slinkyfish/ISC-Project/119_INTELLIGENT_SENSOR_BOARD/119_02v2_INTELLIGENT_SENSOR_BOARD.brd

## EAGLE design 119_INTELLIGENT_SENSOR_BOARD/119_02v2_INTELLIGENT_SENSOR_BOARD.brd (2021-02-11, last stored version)

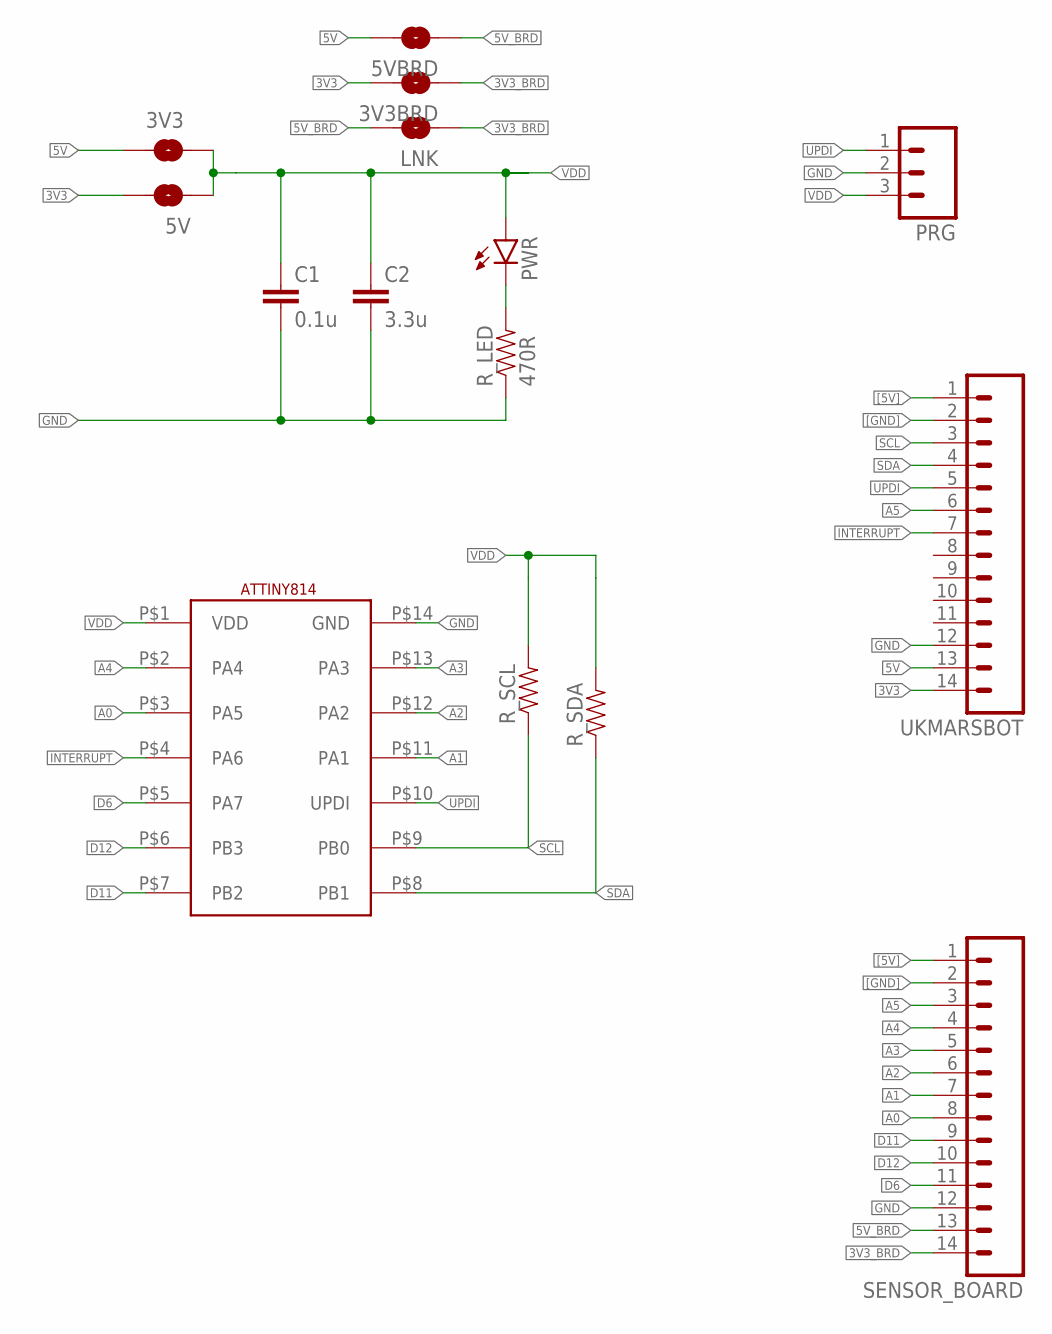
[picture p8: schematic 119_02v2_INTELLIGENT_SENSOR_BOARD.sch]

Parts:
3V3, 3V3BRD, 5V, 5VBRD: JUMPER-SMT_2_NO_SILK; SMT-JUMPER_2_NO_SILK
C1: 0.1u; 0805
C2: 3.3u; 0805
LNK: JUMPER-SMT_2_NO_SILK; SMT-JUMPER_2_NO_SILK
PRG: M03PTH; 1X03
PWR: LEDCHIP-LED0805; CHIP-LED0805
R_LED: 470R; 0805
R_SCL: RESISTOR0805-RES; 0805
R_SDA: RESISTOR0805-RES; 0805
SENSOR_BOARD: M14; 1X14
U$1: ATTINY814
UKMARSBOT: M14; 1X14

Connections:
3V3: 3V3BRD.2, 5V.2, UKMARSBOT.14
3V3_BRD: 3V3BRD.1, LNK.1, SENSOR_BOARD.14
5V: 3V3.2, 5VBRD.2, UKMARSBOT.13
5V_BRD: 5VBRD.1, LNK.2, SENSOR_BOARD.13
A0: SENSOR_BOARD.8, U$1.P$3 (PA5)
A1: SENSOR_BOARD.7, U$1.P$11 (PA1)
A2: SENSOR_BOARD.6, U$1.P$12 (PA2)
A3: SENSOR_BOARD.5, U$1.P$13 (PA3)
A4: SENSOR_BOARD.4, U$1.P$2 (PA4)
A5: SENSOR_BOARD.3, UKMARSBOT.6
D6: SENSOR_BOARD.11, U$1.P$5 (PA7)
D11: SENSOR_BOARD.9, U$1.P$7 (PB2)
D12: SENSOR_BOARD.10, U$1.P$6 (PB3)
GND: C1.2, C2.2, PRG.2, R_LED.1, SENSOR_BOARD.12, U$1.P$14 (GND), UKMARSBOT.12
INTERRUPT: U$1.P$4 (PA6), UKMARSBOT.7
unnamed: PWR.C, R_LED.2
SCL: R_SCL.1, U$1.P$9 (PB0), UKMARSBOT.3
SDA: R_SDA.1, U$1.P$8 (PB1), UKMARSBOT.4
UPDI: PRG.1, U$1.P$10 (UPDI), UKMARSBOT.5
VDD: 3V3.1, 5V.1, C1.1, C2.1, PRG.3, PWR.A, R_SCL.2, R_SDA.2, U$1.P$1 (VDD)
[5V]: SENSOR_BOARD.1, UKMARSBOT.1
[GND]: SENSOR_BOARD.2, UKMARSBOT.2

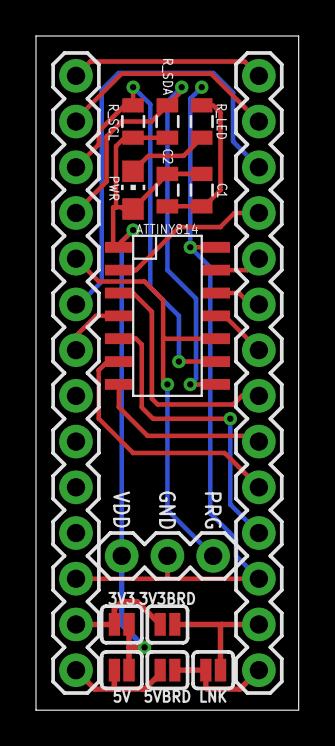
[picture p9: board 119_02v2_INTELLIGENT_SENSOR_BOARD.brd from above]

Board: 2 copper layers, 14.6 x 37.5 mm, 15 parts (0 on the bottom side), 22 nets.
