slinkyfish/ISC-Project/119_INTELLIGENT_SENSOR_BOARD/119_03_INTELLIGENT_SENSOR_BOARD_816.brd

## EAGLE design 119_INTELLIGENT_SENSOR_BOARD/119_03_INTELLIGENT_SENSOR_BOARD_816.brd (2021-02-10, last stored version)

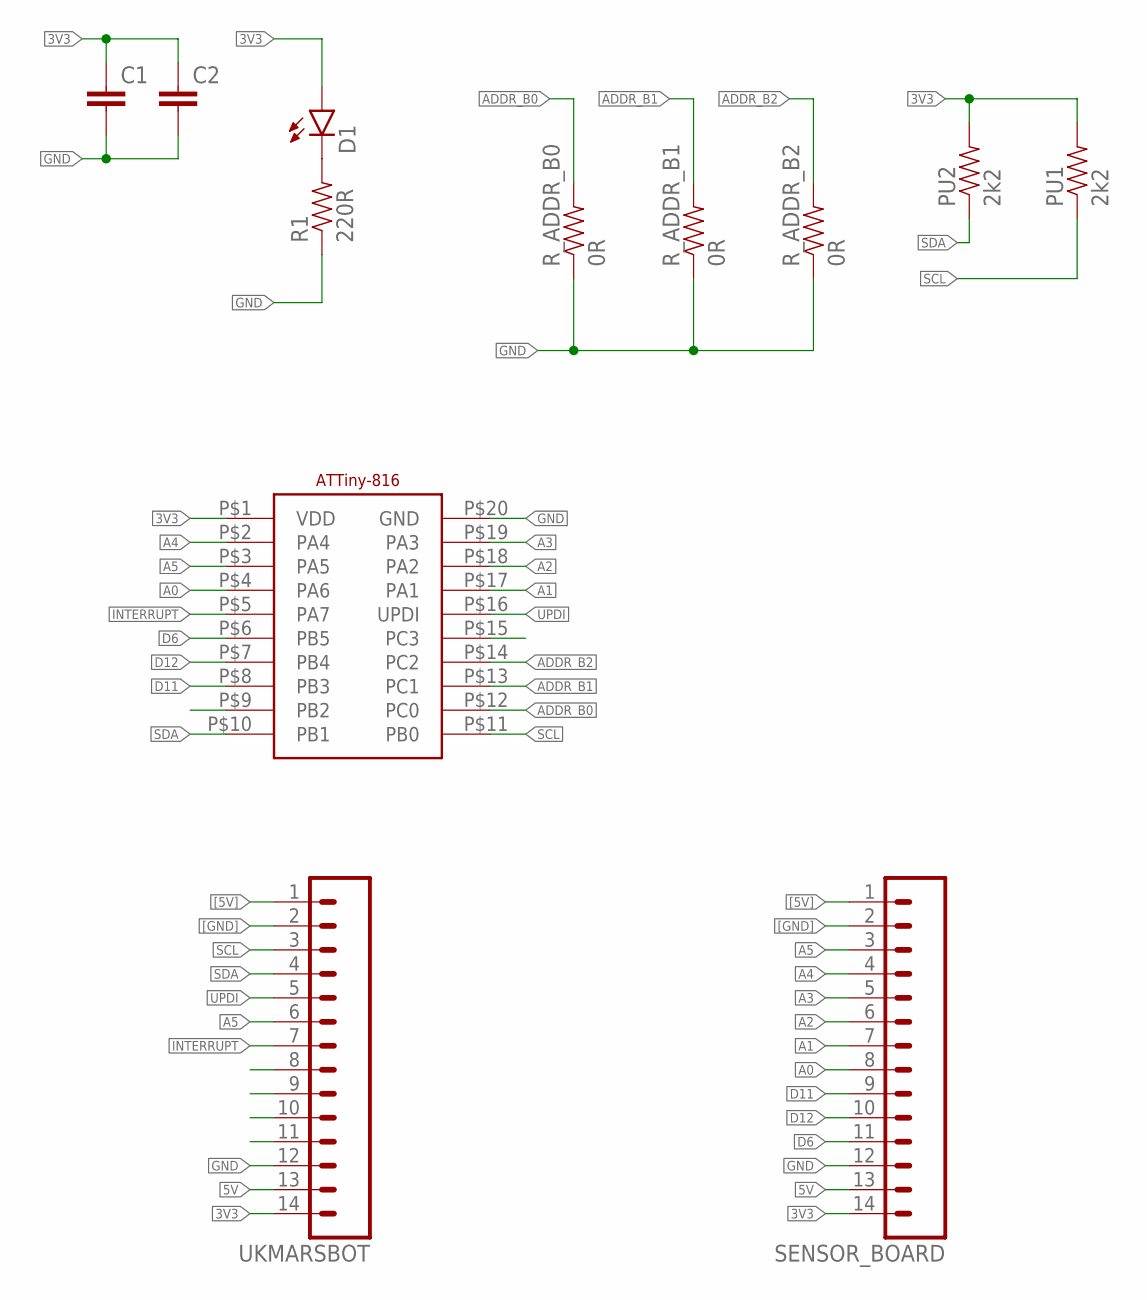
[picture p10: schematic 119_03_INTELLIGENT_SENSOR_BOARD_816.sch]

Parts:
C1, C2: CAP0805; 0805
D1: LEDCHIP-LED0805; CHIP-LED0805
PU1, PU2: 2k2; 0805
R1: 220R; 0805
R_ADDR_B0, R_ADDR_B1, R_ADDR_B2: 0R; 0805
SENSOR_BOARD: M14; 14P
U$2: ATTINY816; ATTINY816_SOIC20
UKMARSBOT: M14; 14P

Connections:
3V3: C1.1, C2.1, D1.A, PU1.2, PU2.2, SENSOR_BOARD.14, U$2.P$1 (VDD), UKMARSBOT.14
5V: SENSOR_BOARD.13, UKMARSBOT.13
A0: SENSOR_BOARD.8, U$2.P$4 (PA6)
A1: SENSOR_BOARD.7, U$2.P$17 (PA1)
A2: SENSOR_BOARD.6, U$2.P$18 (PA2)
A3: SENSOR_BOARD.5, U$2.P$19 (PA3)
A4: SENSOR_BOARD.4, U$2.P$2 (PA4)
A5: SENSOR_BOARD.3, U$2.P$3 (PA5), UKMARSBOT.6
ADDR_B0: R_ADDR_B0.2, U$2.P$12 (PC0)
ADDR_B1: R_ADDR_B1.2, U$2.P$13 (PC1)
ADDR_B2: R_ADDR_B2.2, U$2.P$14 (PC2)
D6: SENSOR_BOARD.11, U$2.P$6 (PB5)
D11: SENSOR_BOARD.9, U$2.P$8 (PB3)
D12: SENSOR_BOARD.10, U$2.P$7 (PB4)
GND: C1.2, C2.2, R1.1, R_ADDR_B0.1, R_ADDR_B1.1, R_ADDR_B2.1, SENSOR_BOARD.12, U$2.P$20 (GND), UKMARSBOT.12
INTERRUPT: U$2.P$5 (PA7), UKMARSBOT.7
unnamed: D1.C, R1.2
SCL: PU1.1, U$2.P$11 (PB0), UKMARSBOT.3
SDA: PU2.1, U$2.P$10 (PB1), UKMARSBOT.4
UPDI: U$2.P$16 (UPDI), UKMARSBOT.5
[5V]: SENSOR_BOARD.1, UKMARSBOT.1
[GND]: SENSOR_BOARD.2, UKMARSBOT.2

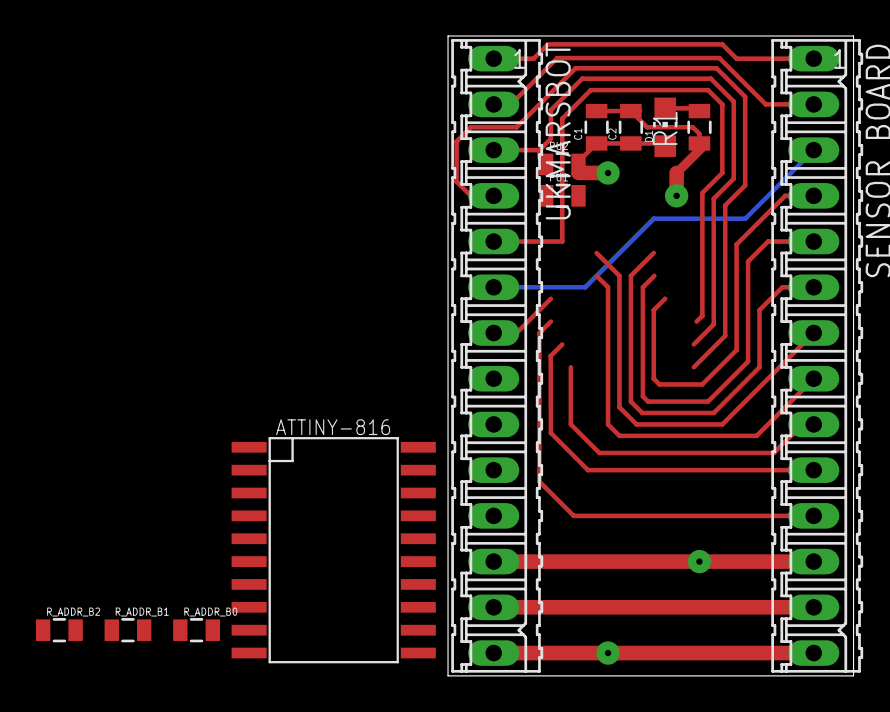
[picture p11: board 119_03_INTELLIGENT_SENSOR_BOARD_816.brd from above]

Board: 2 copper layers, 22.5 x 35.5 mm, 12 parts (0 on the bottom side), 22 nets.
