slinkyfish/ISC-Project/120_ISC_BASE_BOARD/120_01_ISC_BASE_BOARD.brd

## EAGLE design 120_ISC_BASE_BOARD/120_01_ISC_BASE_BOARD.brd (2021-02-10, last stored version)

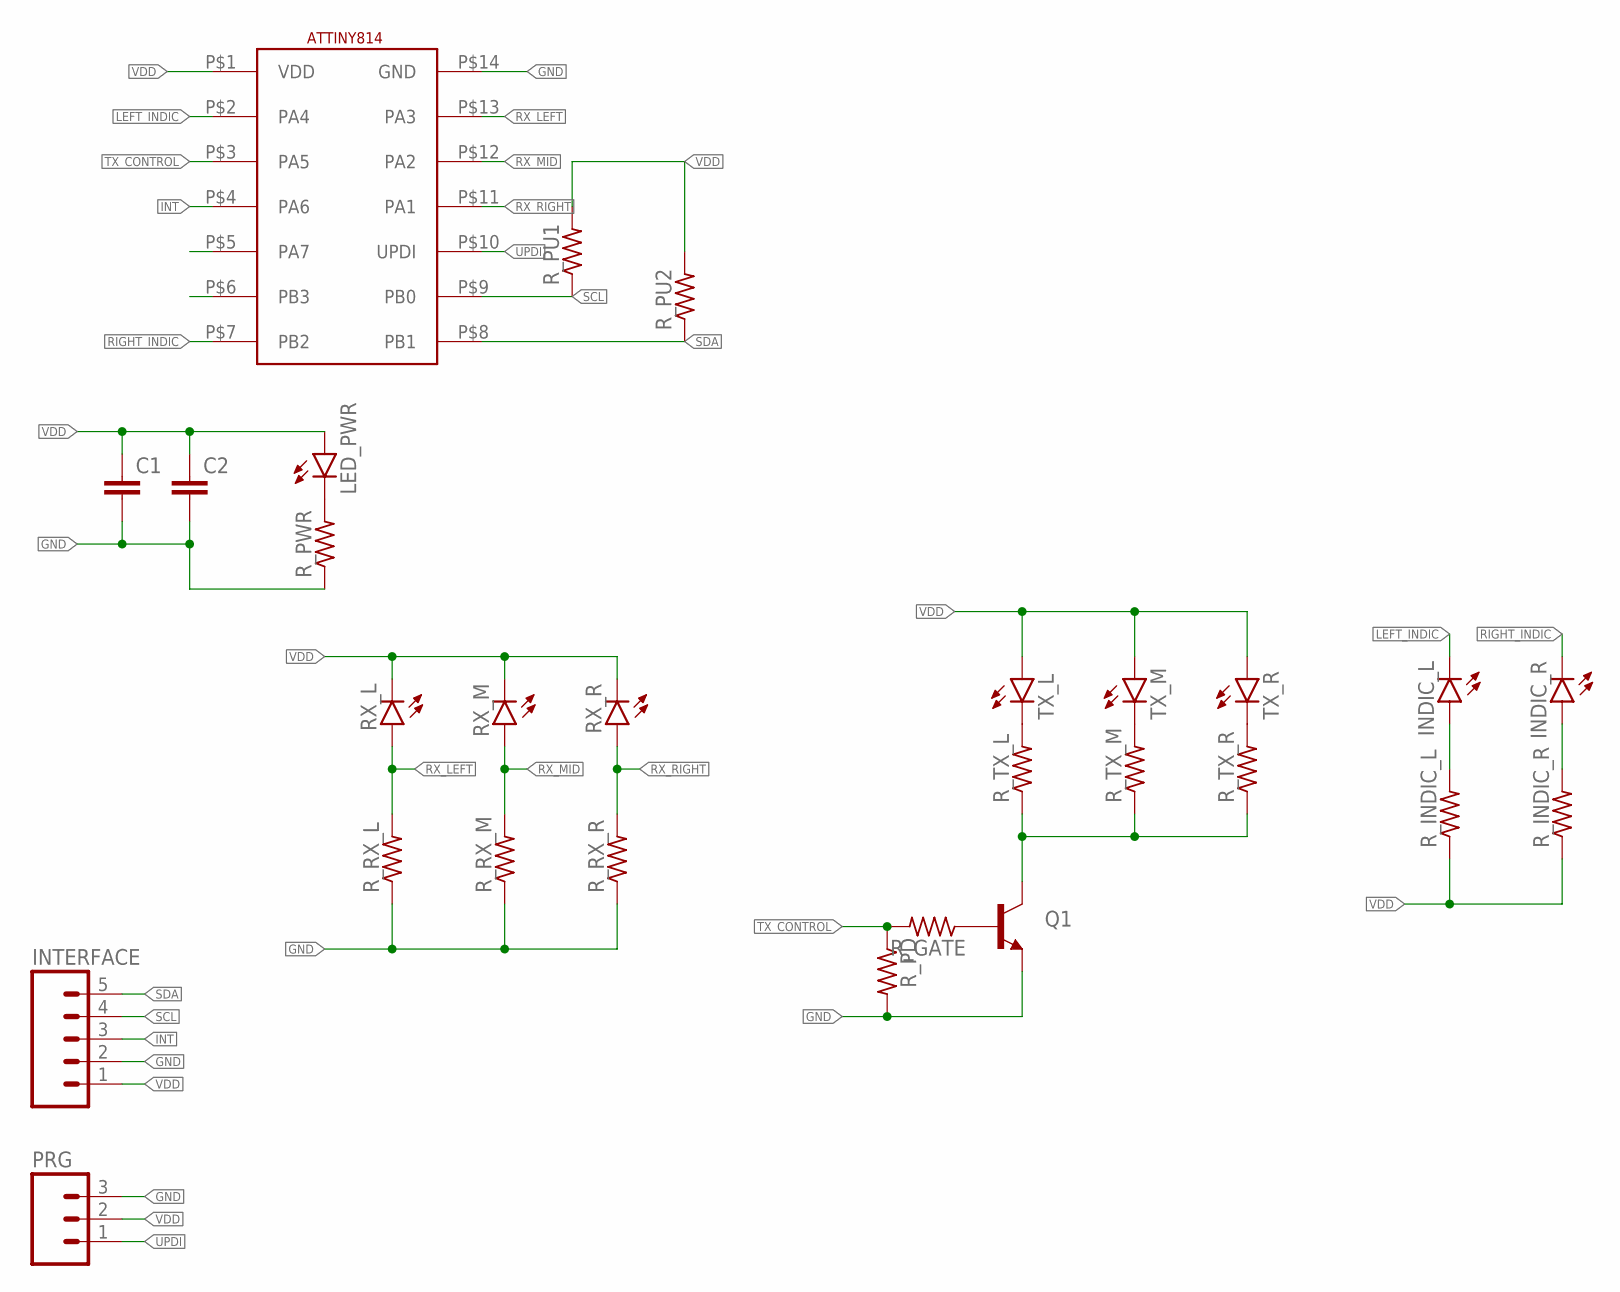
[picture p12: schematic 120_01_ISC_BASE_BOARD.sch]

Parts:
C1, C2: C-EUC0805; C0805
INDIC_L: LED3MM
INDIC_R: LED3MM
INTERFACE: M05NO_SILK; 1X05_NO_SILK
LED_PWR: LEDCHIP-LED0805; CHIP-LED0805
PRG: M03PTH; 1X03
Q1: TRANSISTOR_NPNBC547; TO-92-AMMO
RX_L: LED3MM
RX_M: LED3MM
RX_R: LED3MM
R_GATE: R-US_R0805; R0805
R_INDIC_L: R-US_R0805; R0805
R_INDIC_R: R-US_R0805; R0805
R_PD: R-US_R0805; R0805
R_PU1, R_PU2: R-US_R0805; R0805
R_PWR: R-US_R0805; R0805
R_RX_L: R-US_R0805; R0805
R_RX_M: R-US_R0805; R0805
R_RX_R: R-US_R0805; R0805
R_TX_L: R-US_R0805; R0805
R_TX_M: R-US_R0805; R0805
R_TX_R: R-US_R0805; R0805
TX_L: LED5MM
TX_M: LED5MM
TX_R: LED5MM
U$1: ATTINY814

Connections:
GND: C1.2, C2.2, INTERFACE.2, PRG.3, Q1.3 (E), R_PD.2, R_PWR.1, R_RX_L.1, R_RX_M.1, R_RX_R.1, U$1.P$14 (GND)
INT: INTERFACE.3, U$1.P$4 (PA6)
LEFT_INDIC: INDIC_L.K (C), U$1.P$2 (PA4)
unnamed: LED_PWR.C, R_PWR.2
unnamed: INDIC_L.A, R_INDIC_L.2
unnamed: INDIC_R.A, R_INDIC_R.2
unnamed: R_TX_L.2, TX_L.K (C)
unnamed: R_TX_M.2, TX_M.K (C)
unnamed: R_TX_R.2, TX_R.K (C)
unnamed: Q1.1 (C), R_TX_L.1, R_TX_M.1, R_TX_R.1
unnamed: Q1.2 (B), R_GATE.1
RIGHT_INDIC: INDIC_R.K (C), U$1.P$7 (PB2)
RX_LEFT: RX_L.A, R_RX_L.2, U$1.P$13 (PA3)
RX_MID: RX_M.A, R_RX_M.2, U$1.P$12 (PA2)
RX_RIGHT: RX_R.A, R_RX_R.2, U$1.P$11 (PA1)
SCL: INTERFACE.4, R_PU1.1, U$1.P$9 (PB0)
SDA: INTERFACE.5, R_PU2.1, U$1.P$8 (PB1)
TX_CONTROL: R_GATE.2, R_PD.1, U$1.P$3 (PA5)
UPDI: PRG.1, U$1.P$10 (UPDI)
VDD: C1.1, C2.1, INTERFACE.1, LED_PWR.A, PRG.2, RX_L.K (C), RX_M.K (C), RX_R.K (C), R_INDIC_L.1, R_INDIC_R.1, R_PU1.2, R_PU2.2, TX_L.A, TX_M.A, TX_R.A, U$1.P$1 (VDD)

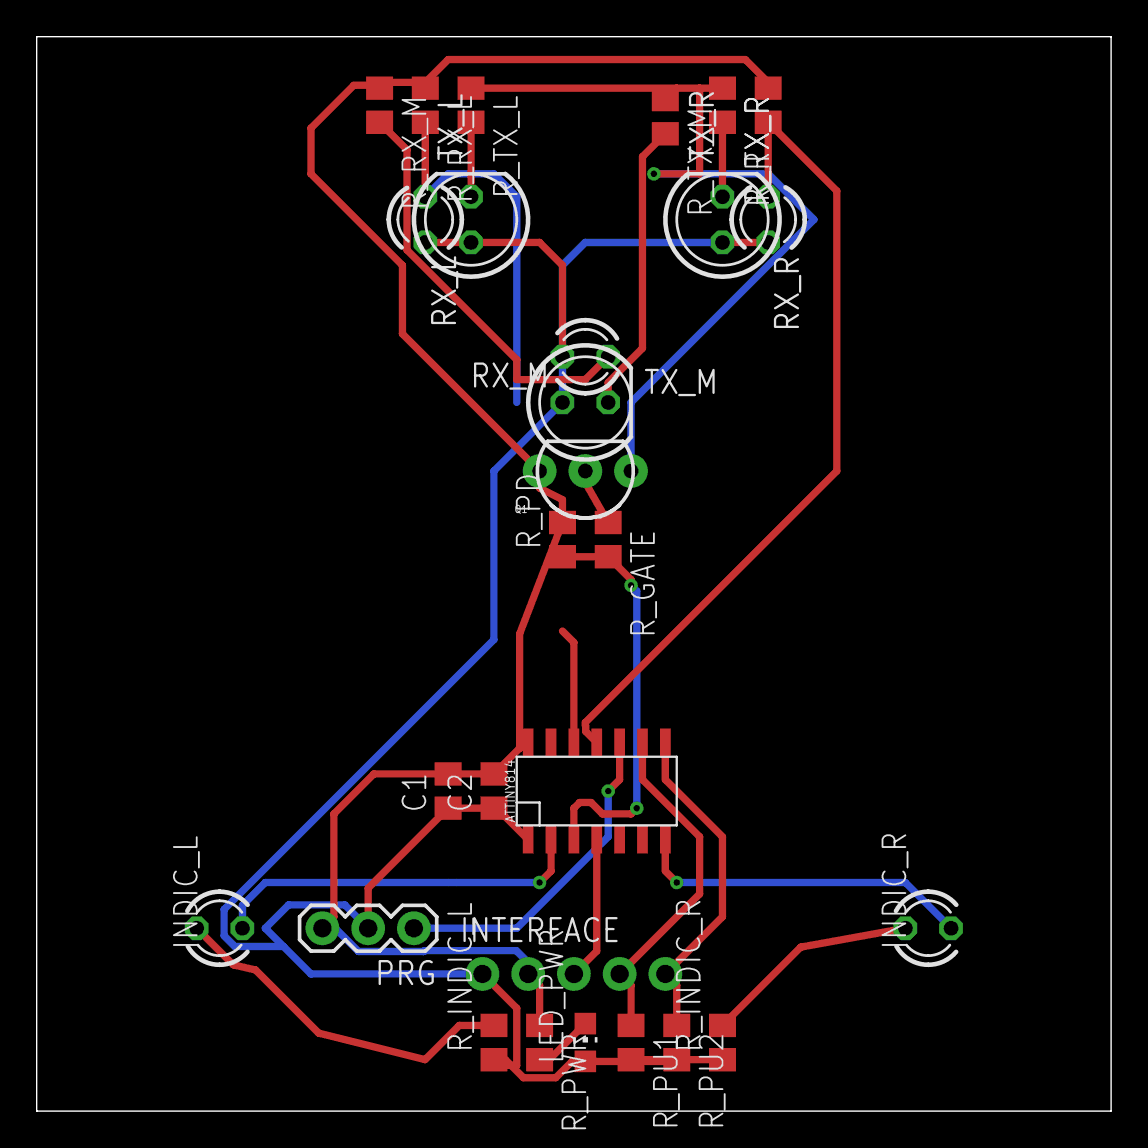
[picture p13: board 120_01_ISC_BASE_BOARD.brd from above]

Board: 2 copper layers, 59.7 x 59.7 mm, 28 parts (0 on the bottom side), 20 nets.
