slinkyfish/ISC-Project/119_INTELLIGENT_SENSOR_BOARD/119_01_INTELLIGENT_SENSOR_BOARD.brd

## EAGLE design 119_INTELLIGENT_SENSOR_BOARD/119_01_INTELLIGENT_SENSOR_BOARD.brd (2021-02-10, last stored version)

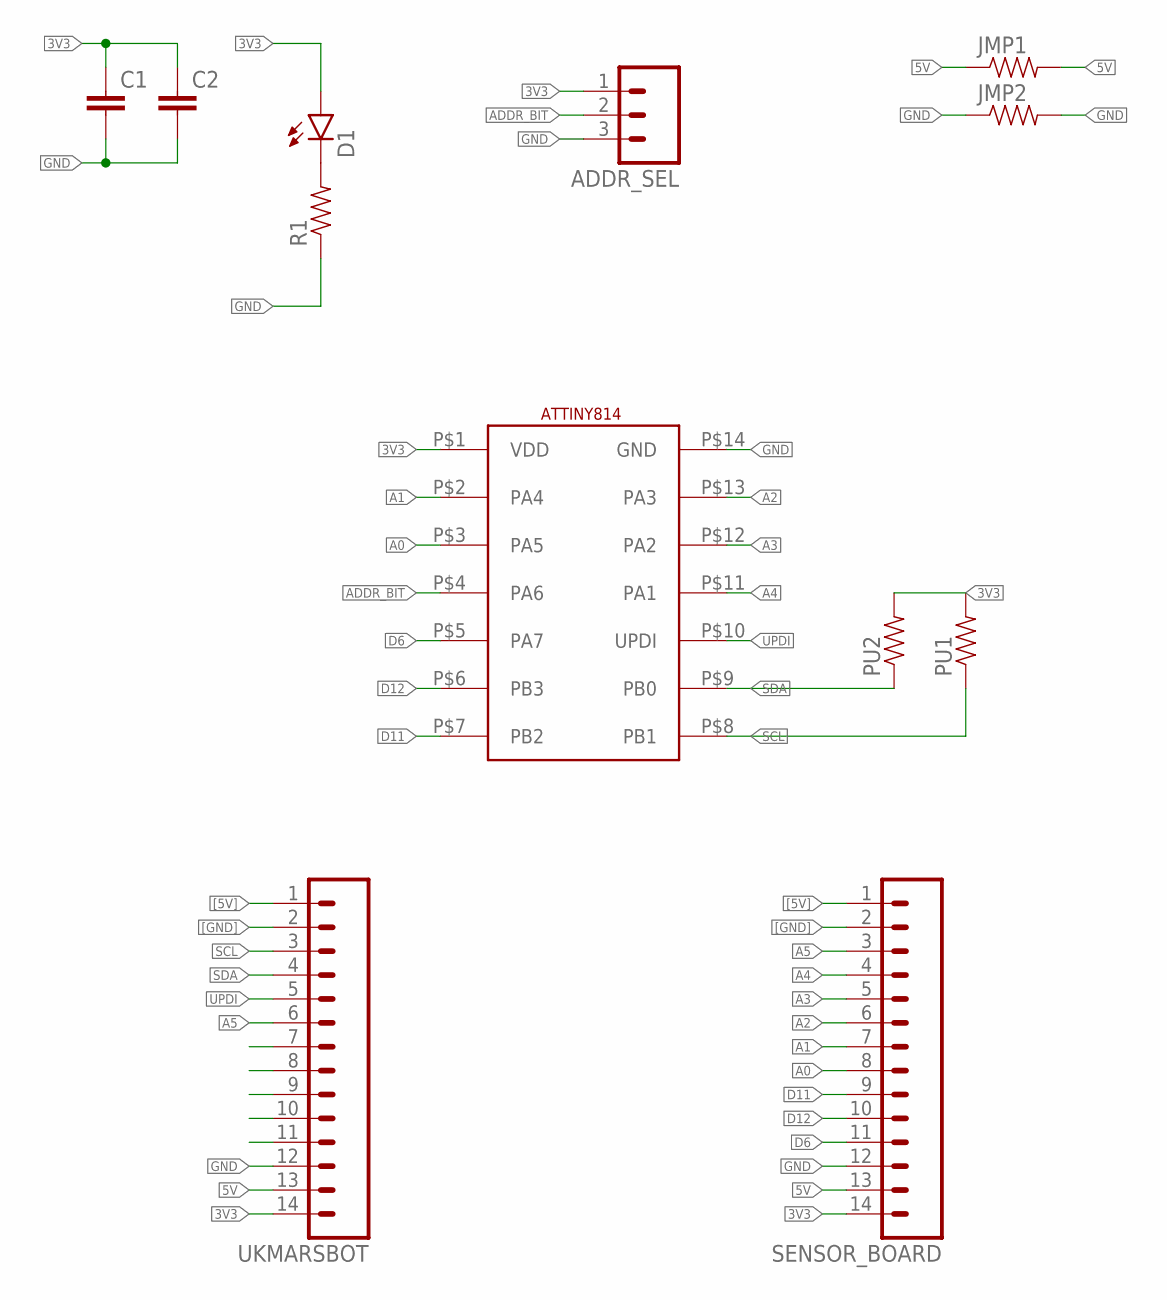
[picture p14: schematic 119_01_INTELLIGENT_SENSOR_BOARD.sch]

Parts:
ADDR_SEL: M03; 03P
C1, C2: CAP0805; 0805
D1: LEDCHIP-LED0805; CHIP-LED0805
JMP1, JMP2: RESISTOR0805-RES; 0805
PU1, PU2: RESISTOR0805-RES; 0805
R1: RESISTOR0805-RES; 0805
SENSOR_BOARD: M14; 14P
U$1: ATTINY814
UKMARSBOT: M14; 14P

Connections:
3V3: ADDR_SEL.1, C1.1, C2.1, D1.A, PU1.2, PU2.2, SENSOR_BOARD.14, U$1.P$1 (VDD), UKMARSBOT.14
5V: JMP1.1, JMP1.2, SENSOR_BOARD.13, UKMARSBOT.13
A0: SENSOR_BOARD.8, U$1.P$3 (PA5)
A1: SENSOR_BOARD.7, U$1.P$2 (PA4)
A2: SENSOR_BOARD.6, U$1.P$13 (PA3)
A3: SENSOR_BOARD.5, U$1.P$12 (PA2)
A4: SENSOR_BOARD.4, U$1.P$11 (PA1)
A5: SENSOR_BOARD.3, UKMARSBOT.6
ADDR_BIT: ADDR_SEL.2, U$1.P$4 (PA6)
D6: SENSOR_BOARD.11, U$1.P$5 (PA7)
D11: SENSOR_BOARD.9, U$1.P$7 (PB2)
D12: SENSOR_BOARD.10, U$1.P$6 (PB3)
GND: ADDR_SEL.3, C1.2, C2.2, JMP2.1, JMP2.2, R1.1, SENSOR_BOARD.12, U$1.P$14 (GND), UKMARSBOT.12
unnamed: D1.C, R1.2
SCL: PU1.1, U$1.P$8 (PB1), UKMARSBOT.3
SDA: PU2.1, U$1.P$9 (PB0), UKMARSBOT.4
UPDI: U$1.P$10 (UPDI), UKMARSBOT.5
[5V]: SENSOR_BOARD.1, UKMARSBOT.1
[GND]: SENSOR_BOARD.2, UKMARSBOT.2

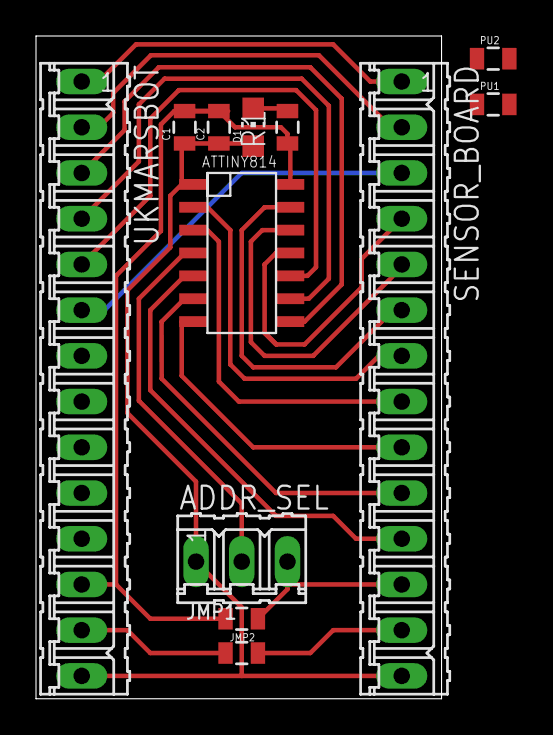
[picture p15: board 119_01_INTELLIGENT_SENSOR_BOARD.brd from above]

Board: 2 copper layers, 22.5 x 36.8 mm, 12 parts (0 on the bottom side), 19 nets.
