slinkyfish/ISC-Project/(commit log)

2021-02-10 Added PCB designs
    [119_01_INTELLIGENT_SENSOR_BOARD.brd, 119_01_INTELLIGENT_SENSOR_BOARD.sch, 119_02_INTELLIGENT_SENSOR_BOARD.brd, 119_02_INTELLIGENT_SENSOR_BOARD.sch, 119_03_INTELLIGENT_SENSOR_BOARD_816.brd, 119_03_INTELLIGENT_SENSOR_BOARD_816.sch, 120_01_ISC_BASE_BOARD.brd, 120_01_ISC_BASE_BOARD.sch]
2021-02-11 Formed new documentation
    Split manual into datasheet, library and notes... added a few more ISC library header defines
    [119_02_INTELLIGENT_SENSOR_BOARD.brd, 119_02_INTELLIGENT_SENSOR_BOARD.sch, 119_02a_INTELLIGENT_SENSOR_BOARD_FOR_MANUAL.brd, 119_02a_INTELLIGENT_SENSOR_BOARD_FOR_MANUAL.sch, 119_02v2_INTELLIGENT_SENSOR_BOARD.brd, 119_02v2_INTELLIGENT_SENSOR_BOARD.sch]
2021-04-05 Published Version 1
    [119_01_INTELLIGENT_SENSOR_BOARD.brd, 119_01_INTELLIGENT_SENSOR_BOARD.sch, 119_02_INTELLIGENT_SENSOR_BOARD.brd, 119_02_INTELLIGENT_SENSOR_BOARD.sch, 119_02a_INTELLIGENT_SENSOR_BOARD_FOR_MANUAL.brd, 119_02a_INTELLIGENT_SENSOR_BOARD_FOR_MANUAL.sch, 119_02v2_INTELLIGENT_SENSOR_BOARD.brd, 119_02v2_INTELLIGENT_SENSOR_BOARD.sch]
